cat101/CasaC/docs/uploads/Conexion termotanque - 161002.pdf

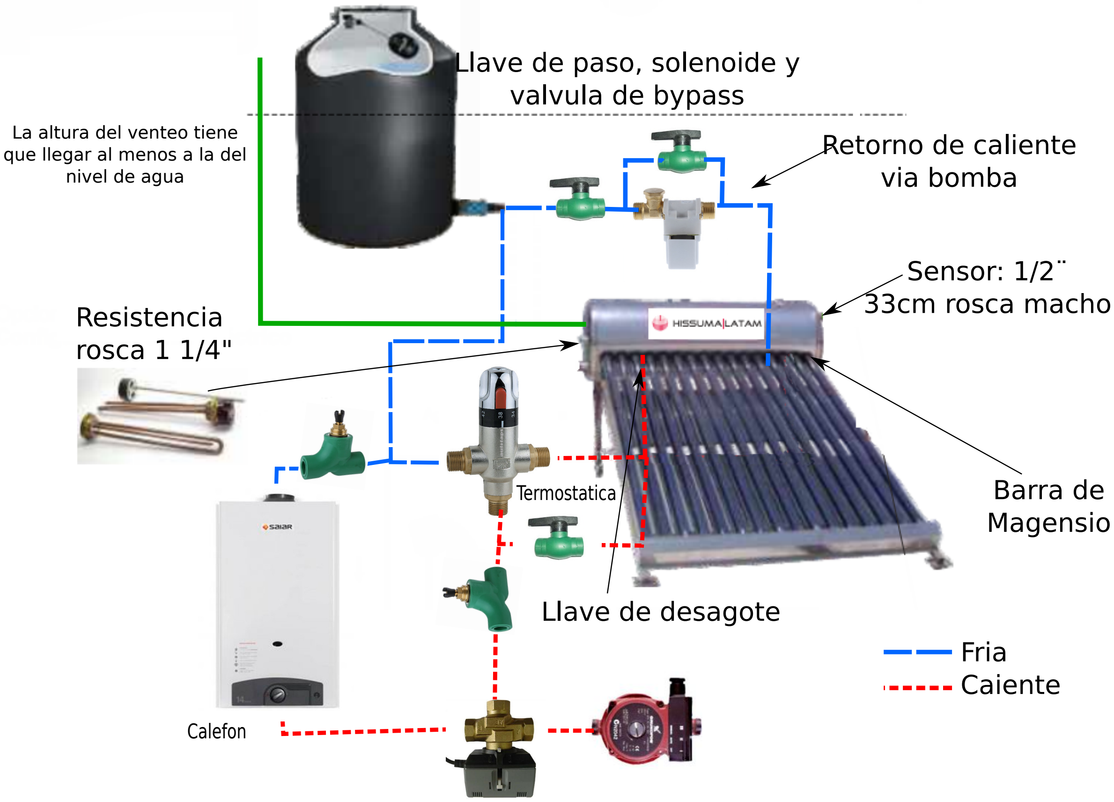
[picture p6: page 1]

Resistencia
rosca 1 1/4¨

Barra de
Magensio

Llave de paso, solenoide y valvula de bypass

La altura del venteo tiene que llegar al menos a la del nivel de agua

Fria
Caiente

Retorno de caliente
via bomba

Llave de desagote

Sensor: 1/2¨
33cm rosca macho

Termostatica

Calefon
