cat101/CasaC/docs/index.md

## Construccion de la CasaC [(español)](sp/index.md)
## Home automation software [(english)](en/index.md)
