cat101/CasaC/docs/uploads/images/Overall automation system.pptx

RS232

In wall

Weather Station

Media Manager

Media Manager

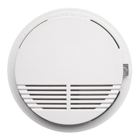
[picture p8: figure]

RS232

RS485

REST

Rest proxy

Data archiver

Building Management

Climate Controller
(Surrogate)

Slave

Master

REST

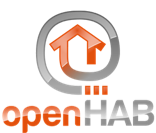
[picture p9: figure]

REST

802.11
(REST)

433Mhz

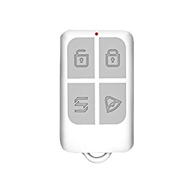
[picture p10: figure]

RS232

Data
warehousing

Home Energy Controller
(Surrogate)
