cat101/CasaC/docs/images/energia1.png

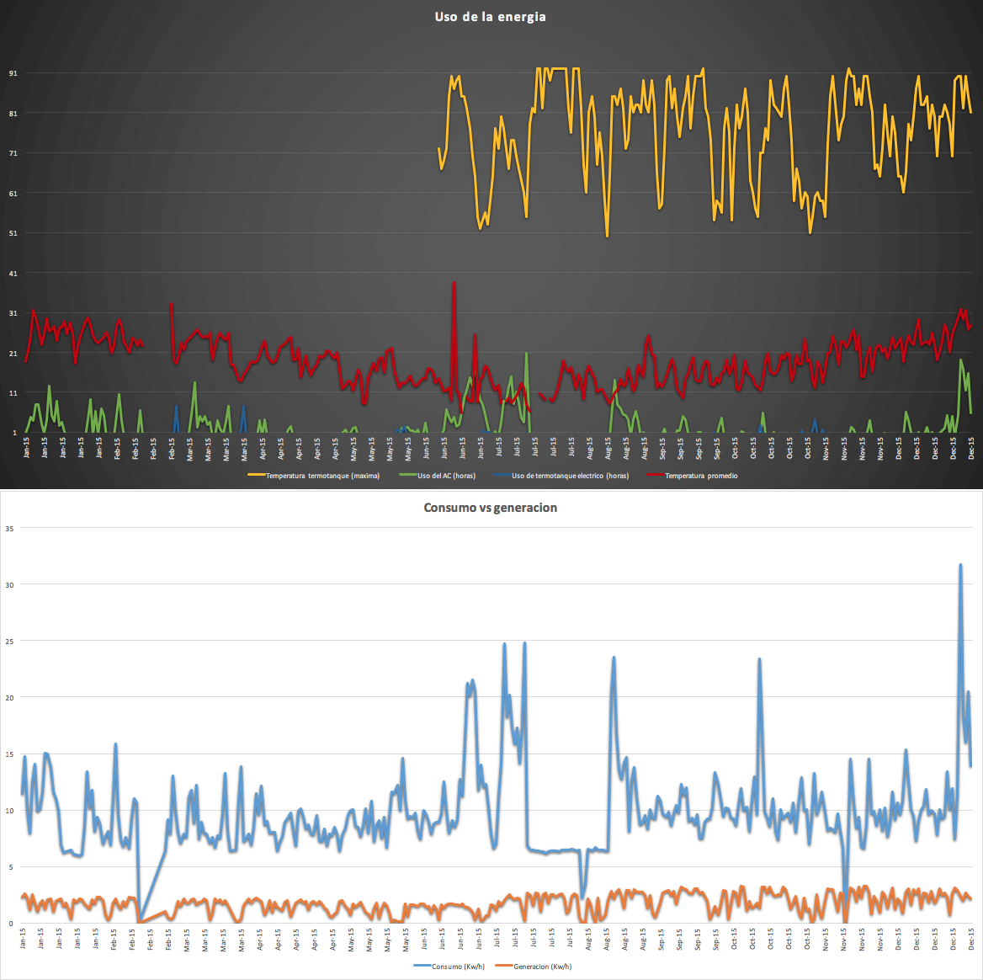
docs/images/energia1.png
