cat101/CasaC/docs/uploads/images/Alarm Zones IO - v3_schem.png

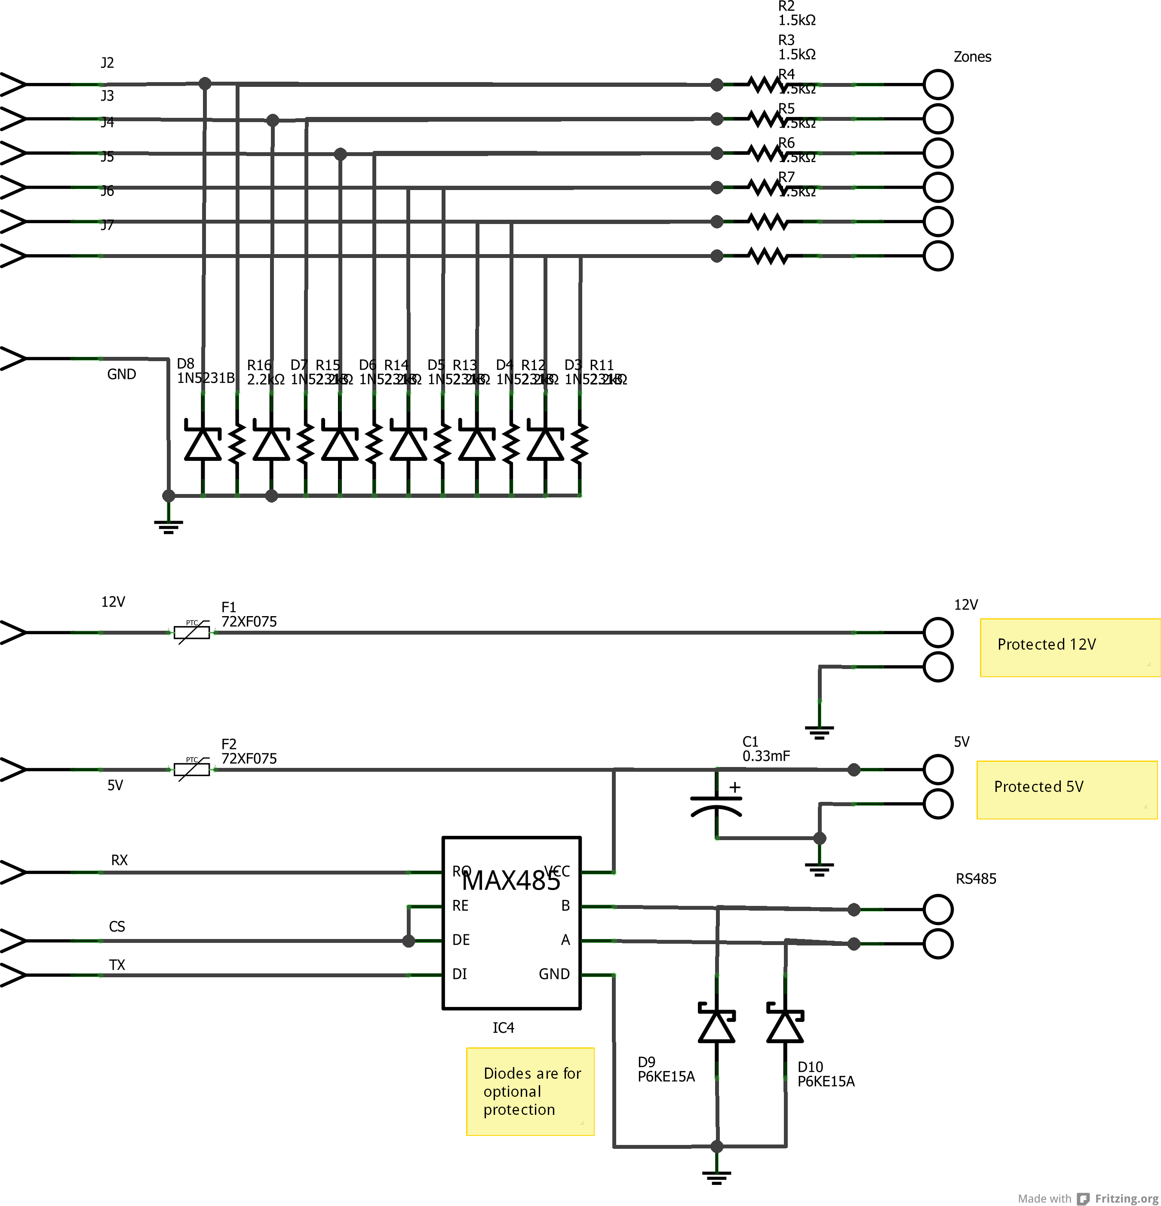
docs/uploads/images/Alarm Zones IO - v3_schem.png
