cat101/CasaC/docs/uploads/images/Amp Module 1.jpg

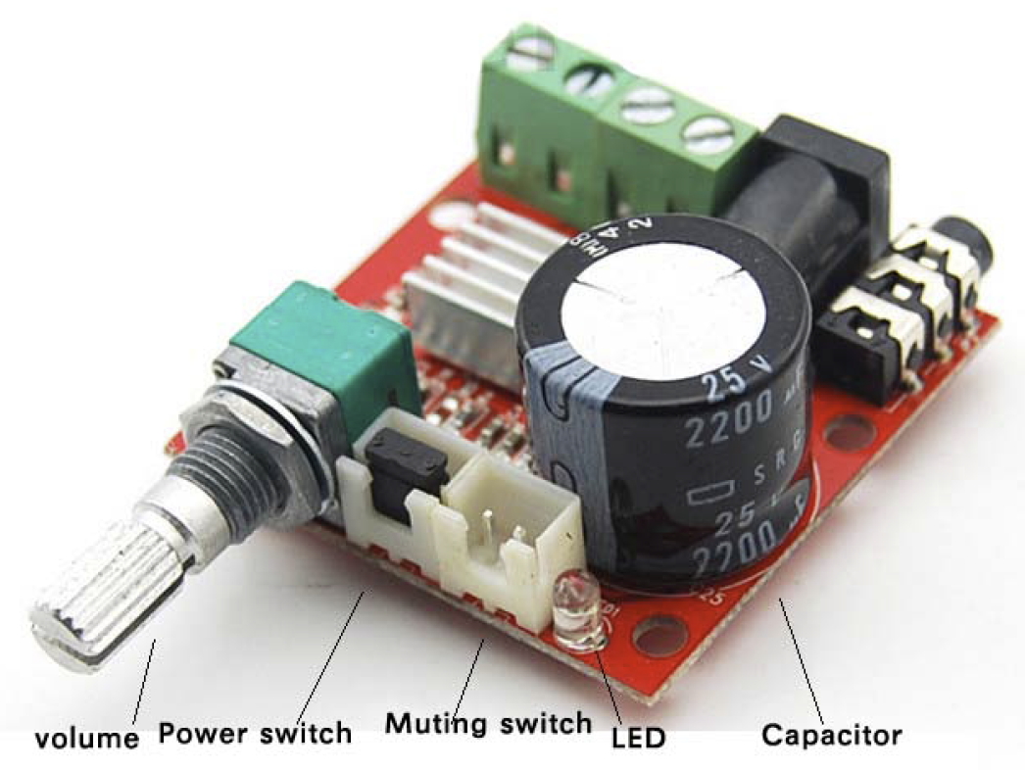
docs/uploads/images/Amp Module 1.jpg
