cat101/CasaC/docs/uploads/images/Amp Module 2.jpg

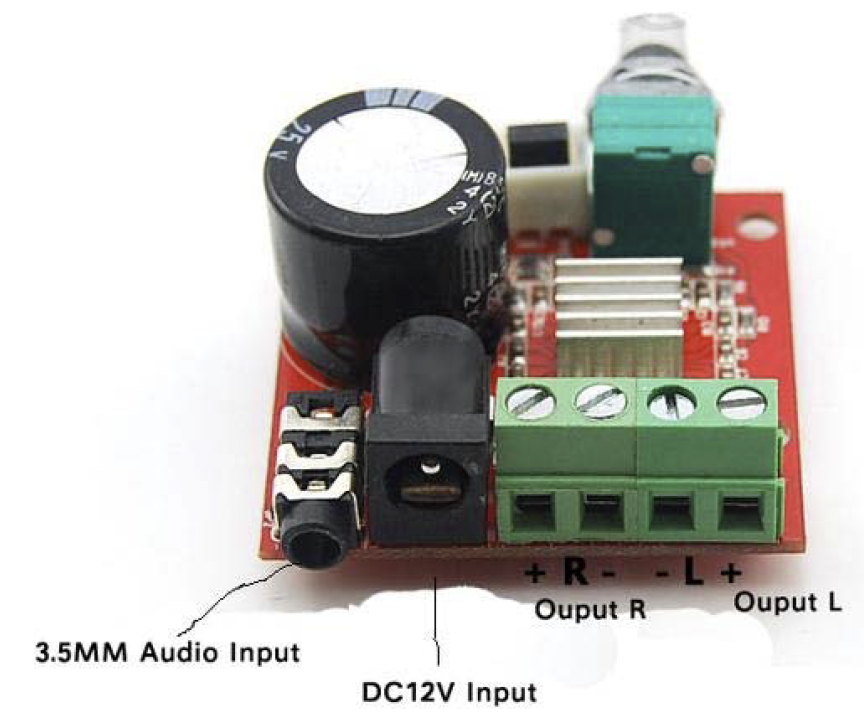
docs/uploads/images/Amp Module 2.jpg
