cat101/CasaC/docs/uploads/images/La CasaC - OpenHab main screen - 201511.png

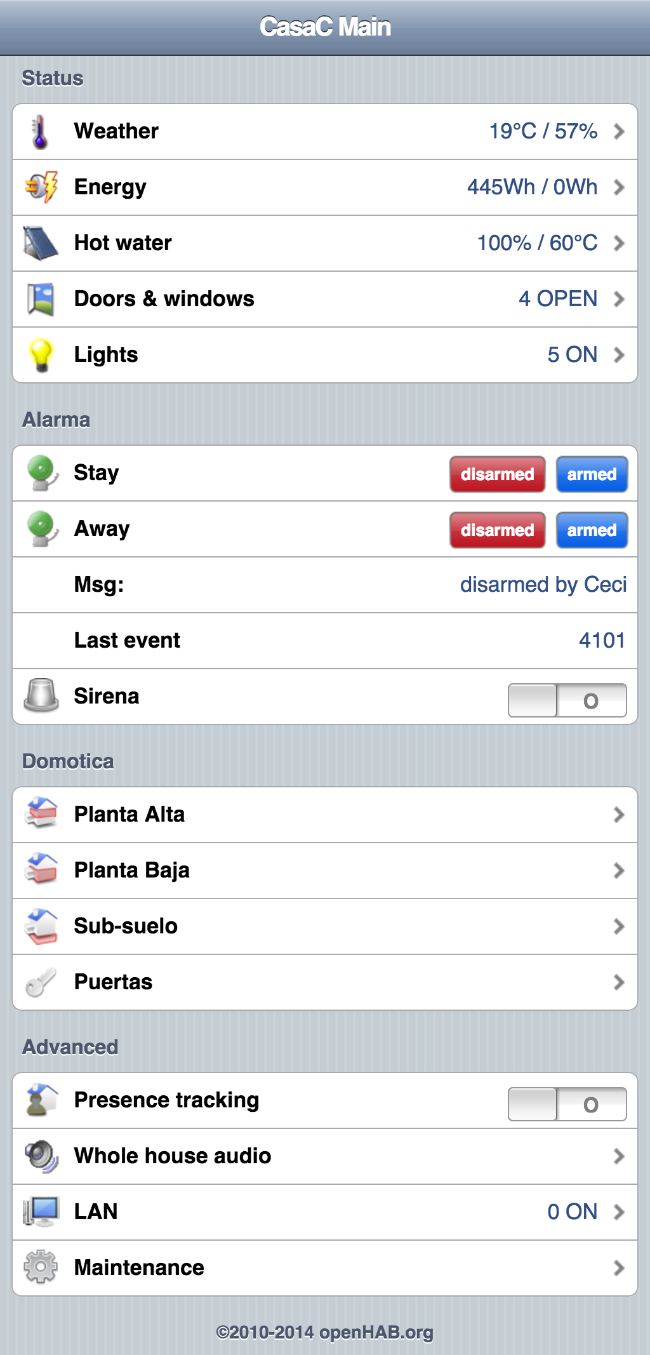
docs/uploads/images/La CasaC - OpenHab main screen - 201511.png
