cat101/CasaC/docs/uploads/images/La CasaC - OpenHab screens - 201704 - 4.png

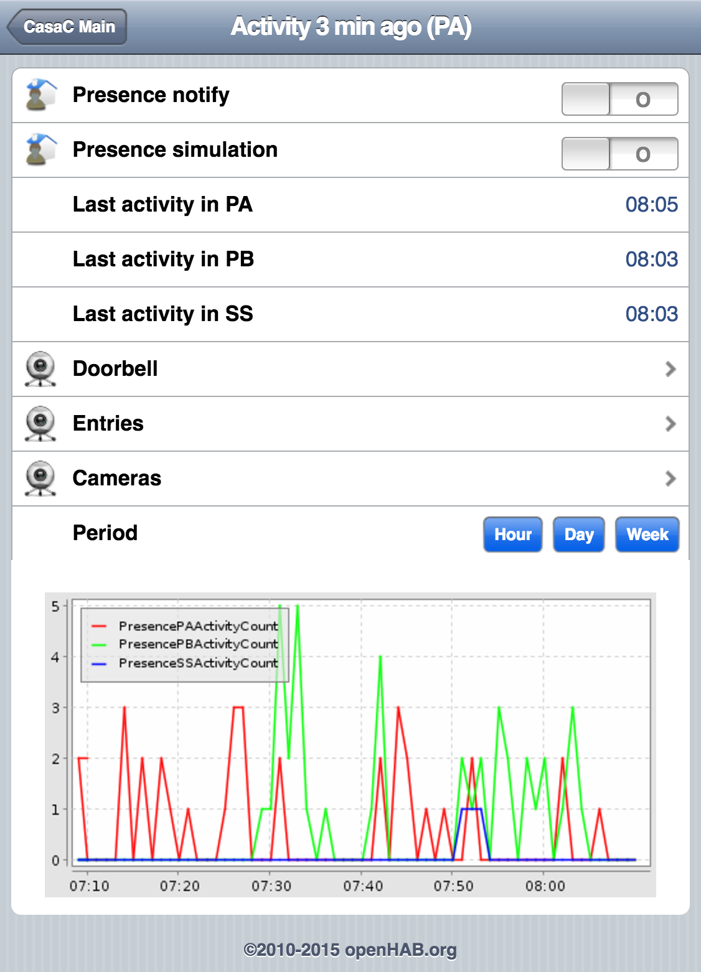
docs/uploads/images/La CasaC - OpenHab screens - 201704 - 4.png
