cat101/CasaC/docs/uploads/images/Light switches - v2_schem.png

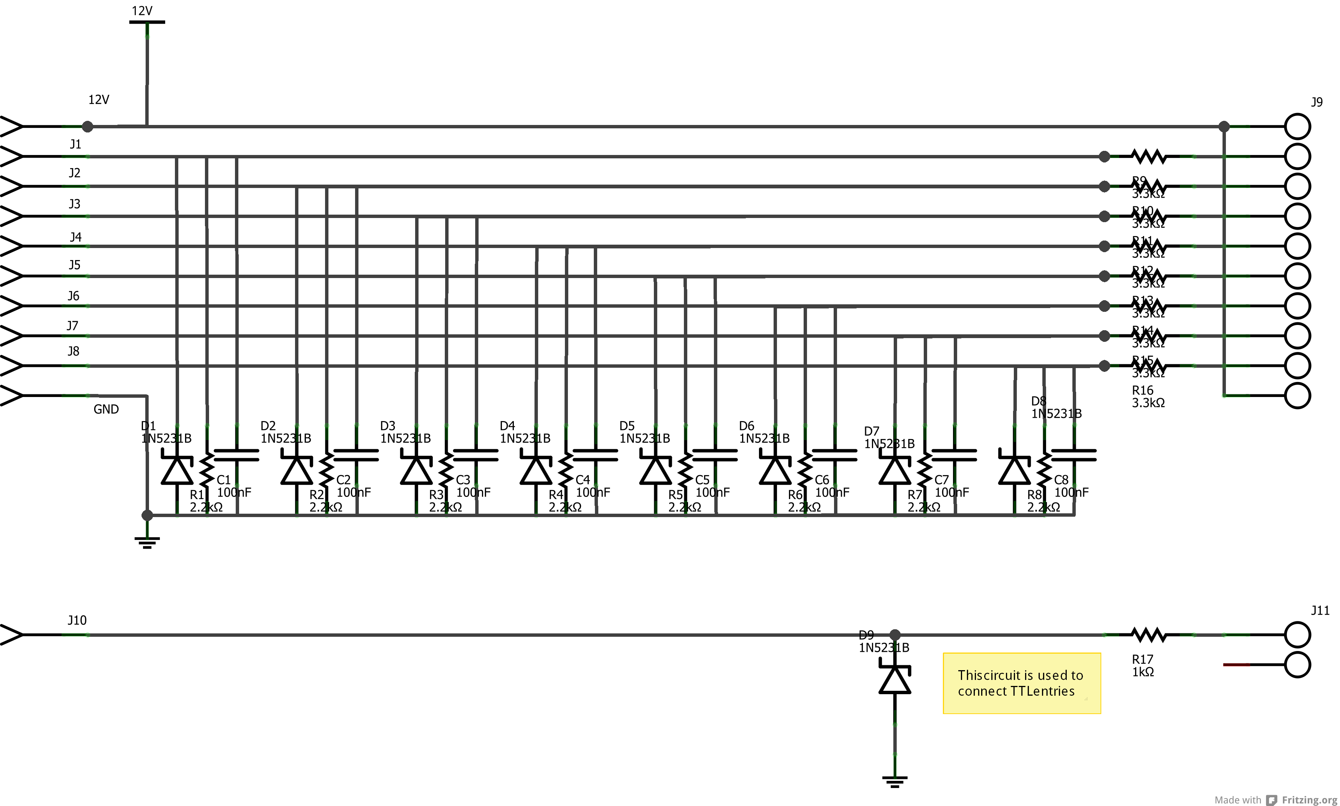
docs/uploads/images/Light switches - v2_schem.png
