cat101/CasaC/docs/uploads/images/SSR 1.png

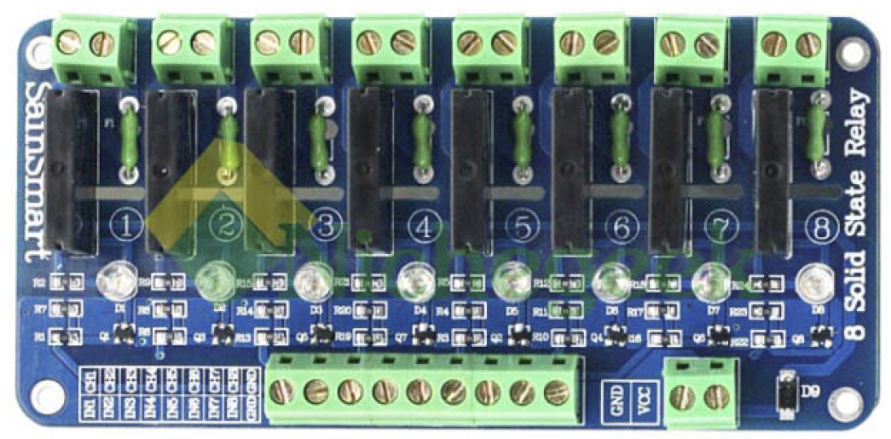
docs/uploads/images/SSR 1.png
