cat101/CasaC/docs/uploads/images/SSR 2.png

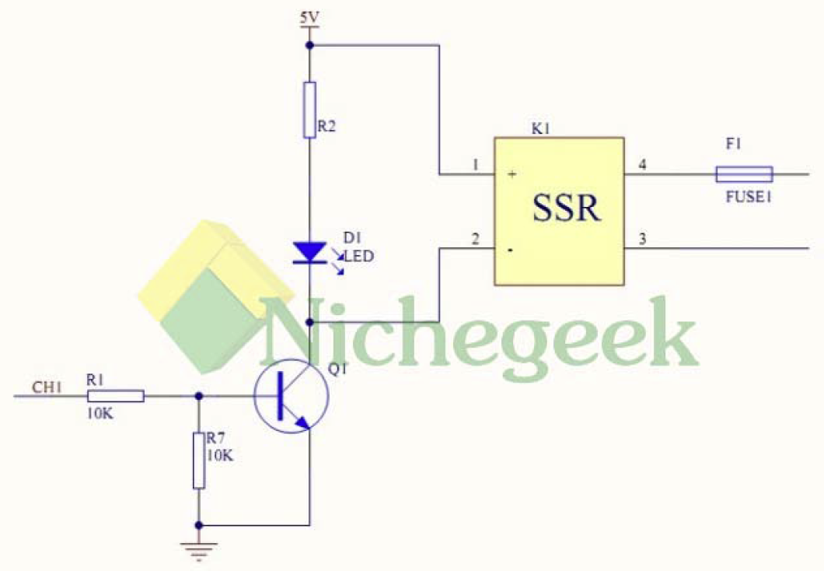
docs/uploads/images/SSR 2.png
