cat101/CasaC/docs/uploads/images/uC Cocina 07.jpg

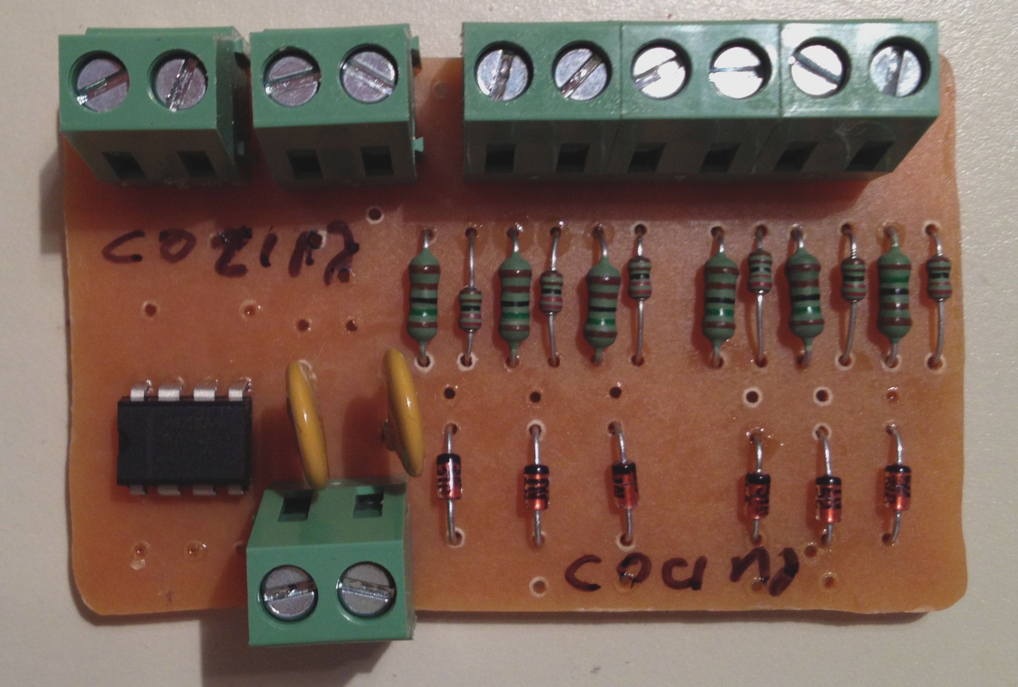
docs/uploads/images/uC Cocina 07.jpg
