cat101/CasaC/docs/uploads/SW diagrams/Alarm Modes.png

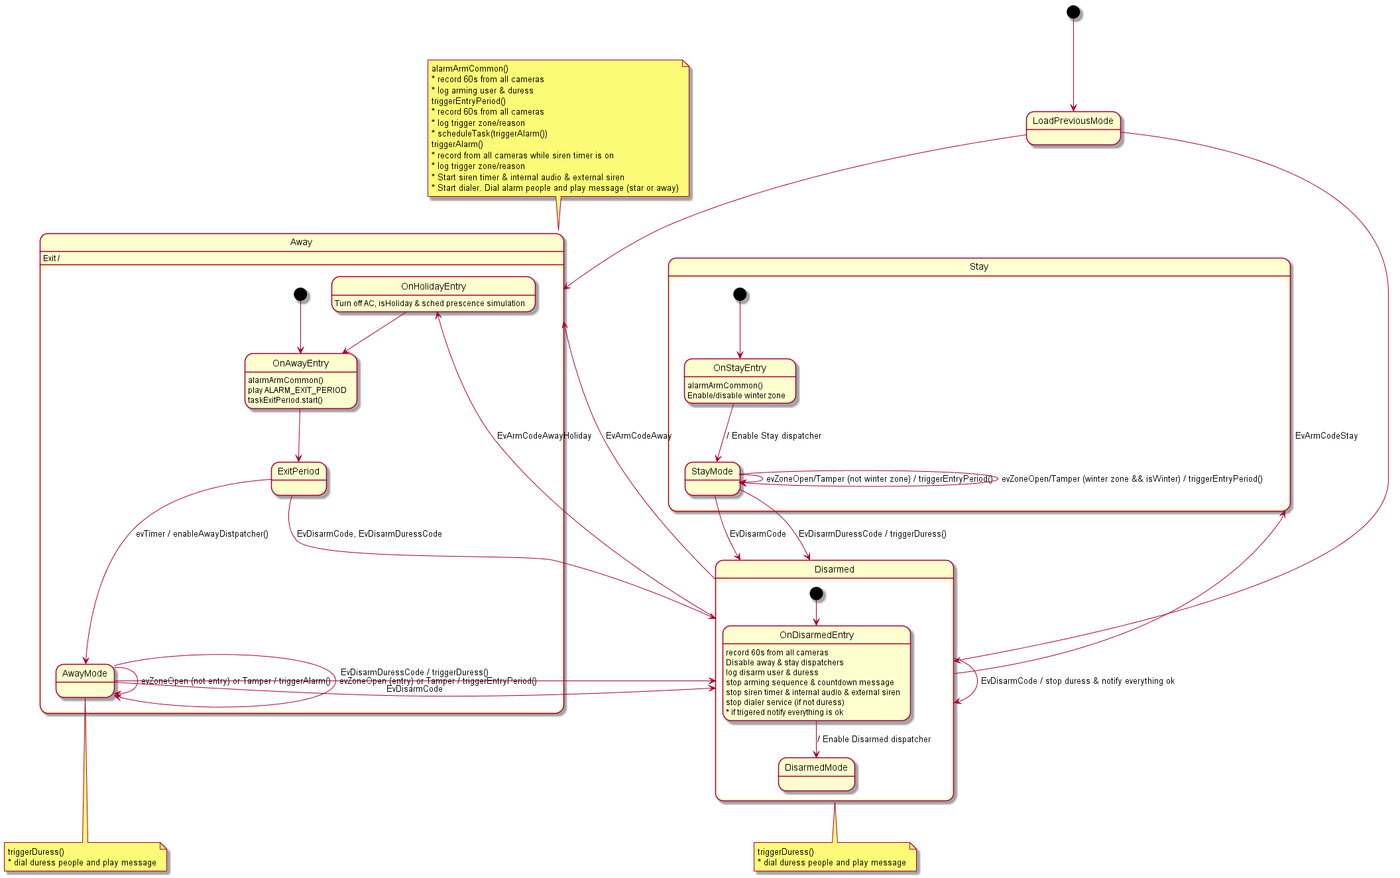
docs/uploads/SW diagrams/Alarm Modes.png
