cat101/CasaC/docs/en/building management/The burglar alarm.md

## The burglar alarm

Key features

- Two modes: stay & away
	- stay mode can be set to winter or summer (some windows can be opened in summer mode)
- Sensor noise immunity: double check sensor state (500ms)
- Spoken commands & countdown
- Ignore open sensors and enroll them on close
- Email/IFTT based alerting
- Presence simulation
- Door access control
- Access control & alarm usage logging
- PIN, RFID and remote based activation
