cat101/CasaC/docs/sp/construccion/Bajo Mantenimiento.md

## Que no se rompa/resilience
* Rebalse de tanque de agua
* Ufer ground
* Descargadores gaseosos
* Estabilizador de tensión

## Limpieza
* Diseño de la casa para el uso de robots
* felpudos
* control de polvo
* lavaplatos
