cat101/CasaC/docs/sp/construccion/Confort.md

## Temperatura agradable
En gran parte el confort de la casa se debe al control de la temperatura y humedad interior. El desafío en la CasaC fue lograr una temperatura agradable en toda la casa y al mismo tiempo limitar el uso de energía externa. Para ello se usaron los siguientes criterios de diseño:

* [Diseño pasivo](Diseno y construccion.md) para capturar energía del sol en invierno y repelerla en verano
* [Construcción de alta aislación](metodo constructivo.md) para reducir la perdida de calor y minimizar las contribuciones externas  no deseadas
* Sectorización de los espacios habitables. La casa tiene cuatro zonas habitables las cuales se climatizan de forma independiente y están divididas con puertas internas de poca conductividad térmica (con burleteria de doble contacto). Las zonas son: social, dormitorios, oficina y baños
* Calefacción/Refrigeración sectorizada y de capacidad variable. La climatizacion activa usa un sistema de Heat Pump (frio/calor) con tecnología inverter el cual permite graduar la cantidad calor o frió inyectado en cada zona. Este sistema complementa muy bien la gran aislación y estanqueidad de la casa. En los baños se instaló calefactores cerámicos con ventilación forzada. El objetivo fue poder enfocar calor en el cuerpo humano de forma eficiente.
* Control de humedad pasivo y activo. En la mayoría de los ambientes el recambio de aire se produce naturalmente por perdidas y en algunos se introdujo rejillas. En los baños se usan extractores mecánicos automáticos para rápidamente evacuar la humedad luego de un baño.

#### Experiencia practica
Estos son algunos de los resultados iniciales en cuanto a la climatizacion e inercia térmica:

* En una zona grande como el living (100m2) se puede subir o bajar 10 grados Celsius en 20 minutos. Los aires comienzan consumiendo 2.5Kw/h y luego bajan 600w/h cuando se alcanza el objetivo. 
* En ambientes con mejor aislación como los dormitorios (44m2) el aire acondicionado logra mantener 20C adentro con 7C afuera trabajando solo 30 minutos por hora y consumiendo 700w/h. 
* En un baño de 3.6m2, alcanza con prender el caloventor de 2000W al comienzo del baño para que el ambiente este agradable al termina el mismo (i.e. 10 min).

## Practicidad en el uso diario

* Manejo de la ropa sucia: En una casa de dos pisos es común tener que subir y bajar ropa desde los dormitorios hacia el lavadero hacia la lavandería. La CasaC cuenta con tubería que permite llevar la ropa sucia desde la planta alta hacia el lavadero
* Manejo de la basura: Con el fin de reducir el volumen de basura y el transporte de la misma por el interior de la casa. La casa tiene un triturador de basura integrado con la pileta de la cocina. Este triturador reduce los restos de comida y los convierte en abono para el reciclado de aguas (compost húmedo). La basura inorgánica es depositada desde la cocina en una tubería que la traslada al exterior de la casa donde es acumulada para luego ser llevada canasto de recolección de basura publica.
* Luces automáticas y de cortesía ([ver eficiencia](Eficiencia energetica.md))

<!-- * Tostadora y microondas
* Dispenser de detergente para 5L
 -->
## Calidad del aire
La casa cuenta con varios filtros de aire los cuales buscan reducir suciedad/polvo, alergias y olores:

* Todos los ambientes tiene filtros de olor y partículas en las unidades de aire acondicionado
* Los ingresos de aire exterior tiene un filtro de partículas
* La heladera tiene un filtro de aire de carbón activado para reducir olores
* La cocina tiene una campana extractora con filtros de grasa y motor externo para reducir ruido

Algunos ambientes cuentan con aromatizadores automáticos con sensor de presencia. Las habitaciones poseen repelentes de mosquitos automáticos los cuales se activan en las noches de verano.

## Calidad del agua 
La casa cuenta con tres etapas de filtrado. El primer filtro remueve las partículas gruesas para proteger la instalación y griferia. Un segundo filtro de carbón activado remueve el cloro antes ingresar al tanque de agua. En la cocina hay un tercer filtro que remueve metales pesados antes del consumo humano.
El tanque de agua se encuentra en el interior de la casa para así garantizar una temperatura de agua agradable todo el año (entre 25 y 17 grados).

## Acondicionamiento eléctrico
La falta de un servicio eléctrico de calidad genera disconfort. En particular la presencia de micro cortes, cortes prolongados, subidas y bajadas de tensión producen intranquilidad y generan fallas en otros servicios (internet, telefono, etc). La CasaC cuenta con varios mecanismos para garantizar un servicio de calidad. Entre ellos se destacan:

 * Un tendido de UPS que permite garantizar la continuidad de servicios como Internet, cámaras de vigilancia, luces en áreas de transito y la operación de portones mecanizados. En condiciones normales la UPS esta dimensionada para garantizar estos servicios por 10 horas. La UPS puede generar 2Kw/h pico y tiene una batería de 12v x 110A (i.e. 1300W).
 * Estabilización de tensión para toda la casa con corte por sobre tensión. Esto garantiza la correcta operación de todos los aparatos eléctricos.
 * En caso de necesitar energía para otros aparatos no conectados a la UPS (aire acondicionados, heladeras, etc) se puede prender un grupo electrógeno el cual cuenta con un transfer switch automatico. 

Para mas información sobre el acondicionamiento eléctrico ver el [esquema eléctrico detallado](../../uploads/Diagramas electricos - circuitos.pdf).
