cat101/CasaC/docs/sp/construccion/Diseno y construccion.md

Las necesidades energéticas de una casa están fuertemente determinadas por el uso de energía para climatización, iluminación y electrodomésticos. El diseño de la misma y el método constructivo son los principales responsables del costo de climatizar e iluminar.

El diseño pasivo busca reducir el uso de energía en climatización ([ver passiv haus](http://en.wikipedia.org/wiki/Passive_solar_design)) e iluminación ([ver day lighting](http://en.wikipedia.org/wiki/Daylighting)). En la CasaC principalmente se tuvieron en cuenta los siguientes aspectos de diseño:

* Orientación y clima
* Aislación de muros y techos
* Aleros
* Toldos, cortinas y esterillas
* Ventilación cruzada

## Orientación y Clima
En Córdoba (Argentina) tenemos casi la misma cantidad de días que requieren calefacción como refrigeración. Esto complejiza el diseño ya que no podemos favorecer una orientación en particular.

Las principales características de los puntos cardinales a la hora de orientar una casa son:

* Oeste: En verano el sol se posiciona en el horizonte (oeste) y se queda ahí por varias horas. Esto hace que todos lo ambientes con cara al oeste sean muy calurosos. La recomendación es poner ambientes "buffer" como baños y placares para minimizar el impacto del sol
* Sur: Esta cara es la esta mas expuesta a lluvias y vientos fuertes. En general se recomienda limitar la cantidad de aberturas al sur y en particular el uso de madera (por el mantenimiento)
* Norte: Esta es la mejor orientación para captar calor en invierno. Es importante poner toldos o aleros que permitan bloquear el paso del sol en verano

## Aislación de muros y techos
* Sistema exacta (ICF): El sistema exacta es un moldaje de EPS liviano permanente y aislante que se rellena de hormigón. En ingles se lo conoce como ([Insultated Concrete Form](https://en.wikipedia.org/wiki/Insulating_concrete_form)). Este sistema se utiliza para hacer muros y lozas. Una de las principales ventajas es la alta aislación térmica que se obtiene. 
* Revoque exterior: Por razones de eficiencia el revoque exterior se hizo utilizando un revoque cementicio proyectado 4 en 1 de Weber (grueso+hidrofugo+fino+color)
* Revoque interior: En el interior se uso yeso proyectado con el objetivo de minimizar la masa térmica interior

![](https://lh3.googleusercontent.com/GGmakvK48u2cxL4TsHRzwZ14-rXBLYU663jqOXVs2bKbvJVPJ2DOX1gT8-DwRqEZPDamLxfJ2tVz3ToGhO9Q8jYeqYKQak1RMqiyAfvS3tegNe6ZhIfLot92guGiAOQLmIj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 "Vista del sistema exacta")
<!-- <img src="https://lh3.googleusercontent.com/GGmakvK48u2cxL4TsHRzwZ14-rXBLYU663jqOXVs2bKbvJVPJ2DOX1gT8-DwRqEZPDamLxfJ2tVz3ToGhO9Q8jYeqYKQak1RMqiyAfvS3tegNe6ZhIfLot92guGiAOQLmIj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" alt="Vista del sistema exacta" style="width: 300px;"/> -->

## Aberturas y films
Todas las aberturas son de PVC (perfileria Rehaus) con doble vidrio (DVH). En las aberturas con orientación oeste se coloco un film de control solar para reducir la insolación de verano (SolarGard Sentinel Outside Weatherable Film Silver).
<!-- <img src="https://lh3.googleusercontent.com/6DuCjeThkZ8-ejc9ajozU_i7Mgm_AHSlU3IFuVKtLeIZuNhm_F9B-ZK_d-c1wh0biIwMDLvUU5wOqA=w2048-h1536-no" alt="Perfileria PVC" style="width: 300px;"/> -->
Perfileria PVC

## Aleros
Todas las ventana de la casa tienen aleros. Estos sirven para prevenir que la lluvia entre por la ventana y a su vez bloquear el sol de verano. En particular en las aberturas con orientación norte, el largo del alero deja pasar el sol en invierno. Esto crea una especie de efecto Trombe donde las aberturas no dejan que el calor escape y el revoque interno de yeso funciona de masa térmica.
<!-- <img src="https://lh3.googleusercontent.com/FChzlnQdkR0Hp8FFSGANyCXanFuixmC3YufVqBqaTzYiQ4TPqv45j_8ibNLdGgMm92WgiJ_pfJiseA=w2048-h1536-no" alt="Aleros" style="width: 300px;"/> -->
Aleros

## Toldos, cortinas y esterillas
En el interior usamos cortinas blackout para oscurecer los ambientes. En algunas ventanas claves tenemos toldos verticales y esterillas que ayudan a reducir la insolación de verano. Los toldos son controlados por computadora para ir bloqueando progresivamente la entrada de sol en verano.

## Ventilación cruzada
Por razones energéticas y de salud, el diseño de la casa contemplo el uso de ventilación natural. En particular todos los pisos poseen aberturas en la cara norte y sur para aprovechar los vientos predominantes en Córdoba. También tenemos aberturas en el sótano y en la plata superior para usar el efecto chimenea para evacuar el calor en verano.
