cat101/CasaC/docs/sp/construccion/Sustentabilidad.md

* Separación de aguas

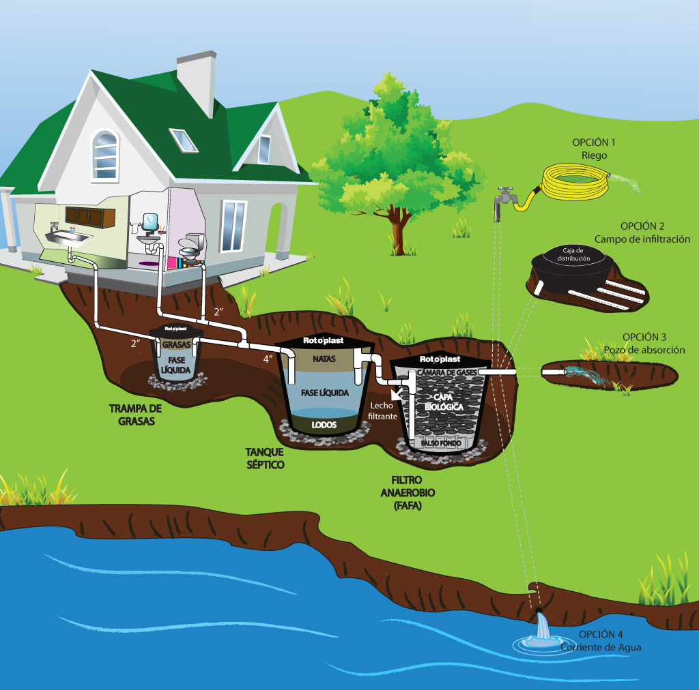
[picture p33: docs/images/Sistema-septico-domiciliario-diagrama.jpg]
Sistema de tratamiento de aguas negras


* Compost seco y húmedo
